UWCubeSat/EPS/README.md

# [Electrical Power System](https://online.huskysatellitelab.com/wiki/index.php/Electrical_Power_System)
