UWCubeSat/EPS/testing boards/BQ25798/BQ25798.kicad_pcb

## KiCad design testing boards/BQ25798/BQ25798.kicad_pcb (2022-05-17)

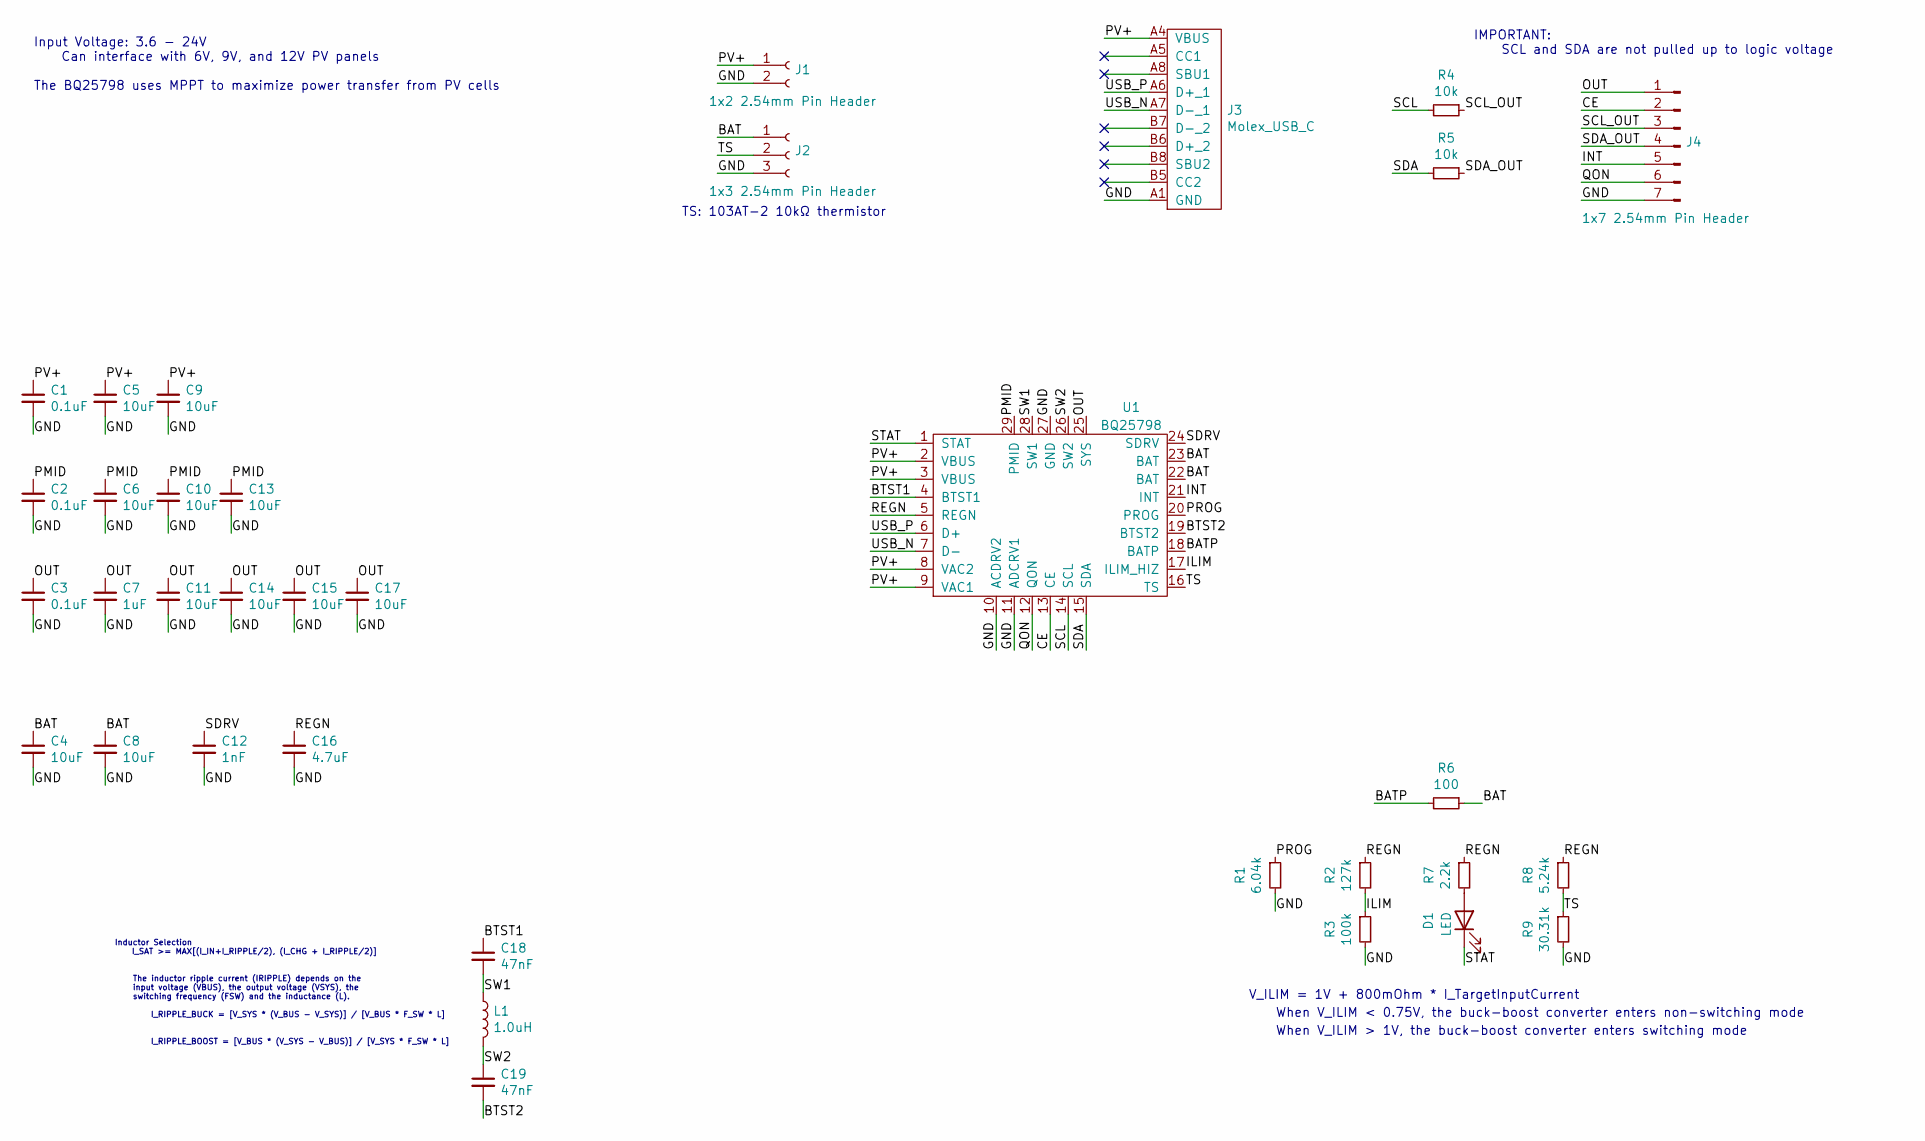
[picture p1: schematic BQ25798.sch]

Parts:
C1, C2, C3: 0.1uF; C_0603_1608Metric
C4, C5, C6, C8, C9, C10, C11, C13, C14, C15, C17: 10uF; C_0603_1608Metric
C7: 1uF; C_0603_1608Metric
C12: 1nF; C_0603_1608Metric
C16: 4.7uF; C_0603_1608Metric
C18, C19: 47nF; C_0603_1608Metric
D1: LED; LED_0402_1005Metric
J1: 1x2 2.54mm Pin Header; PinHeader_1x02_P2.54mm_Vertical
J2: 1x3 2.54mm Pin Header; PinHeader_1x03_P2.54mm_Vertical
J3: Molex_USB_C; USB-C
J4: 1x7 2.54mm Pin Header; PinHeader_1x07_P2.54mm_Vertical
L1: 1.0uH; L_0805_2012Metric
R1: 6.04k; R_0402_1005Metric
R2: 127k; R_0402_1005Metric
R3: 100k; R_0402_1005Metric
R4, R5: 10k; R_0402_1005Metric
R6: 100; R_0402_1005Metric
R7: 2.2k; R_0402_1005Metric
R8: 5.24k; R_0402_1005Metric
R9: 30.31k; R_0402_1005Metric
U1: BQ25798

Connections:
/BAT: C4.1, C8.1, J2.1, R6.1, U1.22 (BAT), U1.23 (BAT)
/BATP: R6.2, U1.18 (BATP)
/BTST1: C18.1, U1.4 (BTST1)
/BTST2: C19.2, U1.19 (BTST2)
/CE: J4.2, U1.13 (CE)
/GND: C1.2, C2.2, C3.2, C4.2, C5.2, C6.2, C7.2, C8.2, C9.2, C10.2, C11.2, C12.2, C13.2, C14.2, C15.2, C16.2, C17.2, J1.2, J2.3, J3.A1 (GND), J4.7, R1.2, R3.2, R9.2, U1.10 (ACDRV2), U1.11 (ADCRV1), U1.27 (GND)
/ILIM: R2.2, R3.1, U1.17 (ILIM_HIZ)
/INT: J4.5, U1.21 (INT)
/OUT: C3.1, C7.1, C11.1, C14.1, C15.1, C17.1, J4.1, U1.25 (SYS)
/PMID: C2.1, C6.1, C10.1, C13.1, U1.29 (PMID)
/PROG: R1.1, U1.20 (PROG)
/PV+: C1.1, C5.1, C9.1, J1.1, J3.A4 (VBUS), U1.2 (VBUS), U1.3 (VBUS), U1.8 (VAC2), U1.9 (VAC1)
/QON: J4.6, U1.12 (QON)
/REGN: C16.1, R2.1, R7.1, R8.1, U1.5 (REGN)
/SCL: R4.2, U1.14 (SCL)
/SCL_OUT: J4.3, R4.1
/SDA: R5.2, U1.15 (SDA)
/SDA_OUT: J4.4, R5.1
/SDRV: C12.1, U1.24 (SDRV)
/STAT: D1.1 (K), U1.1 (STAT)
/SW1: C18.2, L1.1, U1.28 (SW1)
/SW2: C19.1, L1.2, U1.26 (SW2)
/TS: J2.2, R8.2, R9.1, U1.16 (TS)
/USB_N: J3.A7 (D-_1), U1.7 (D-)
/USB_P: J3.A6 (D+_1), U1.6 (D+)
unnamed: D1.2 (A), R7.2

Notes on the sheet:
Input Voltage: 3.6 - 24V Can interface with 6V, 9V, and 12V PV panels The BQ25798 uses MPPT to maximize power transfer from PV cells
Inductor Selection I_SAT >= MAX[(I_IN+I_RIPPLE/2), (I_CHG + I_RIPPLE/2)]
I_RIPPLE_BUCK = [V_SYS * (V_BUS - V_SYS)] / [V_BUS * F_SW * L]
I_RIPPLE_BOOST = [V_BUS * (V_SYS - V_BUS)] / [V_SYS * F_SW * L]
The inductor ripple current (IRIPPLE) depends on the input voltage (VBUS), the output voltage (VSYS), the switching frequency (FSW) and the inductance (L).
V_ILIM = 1V + 800mOhm * I_TargetInputCurrent
When V_ILIM < 0.75V, the buck-boost converter enters non-switching mode
When V_ILIM > 1V, the buck-boost converter enters switching mode
IMPORTANT: SCL and SDA are not pulled up to logic voltage
TS: 103AT-2 10kΩ thermistor

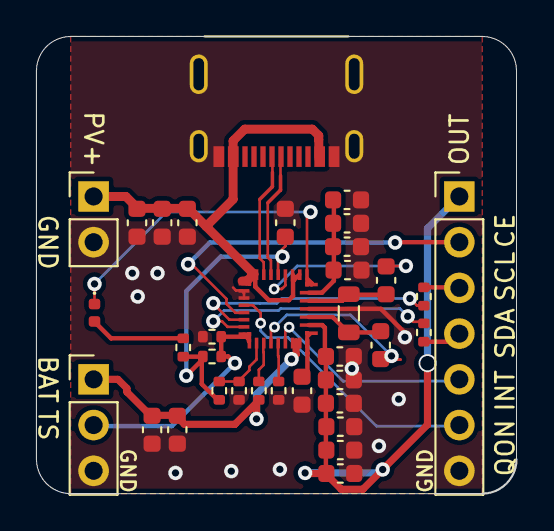
[picture p2: board BQ25798.kicad_pcb from above]

Board: 2 copper layers, 26.7 x 25.4 mm, 35 parts (0 on the bottom side), 26 nets.
