UWCubeSat/EPS/testing boards/EFuse_and_Load_Switch/EFuse_and_Load_Switch.kicad_pcb

## KiCad design testing boards/EFuse_and_Load_Switch/EFuse_and_Load_Switch.kicad_pcb (2022-05-17)

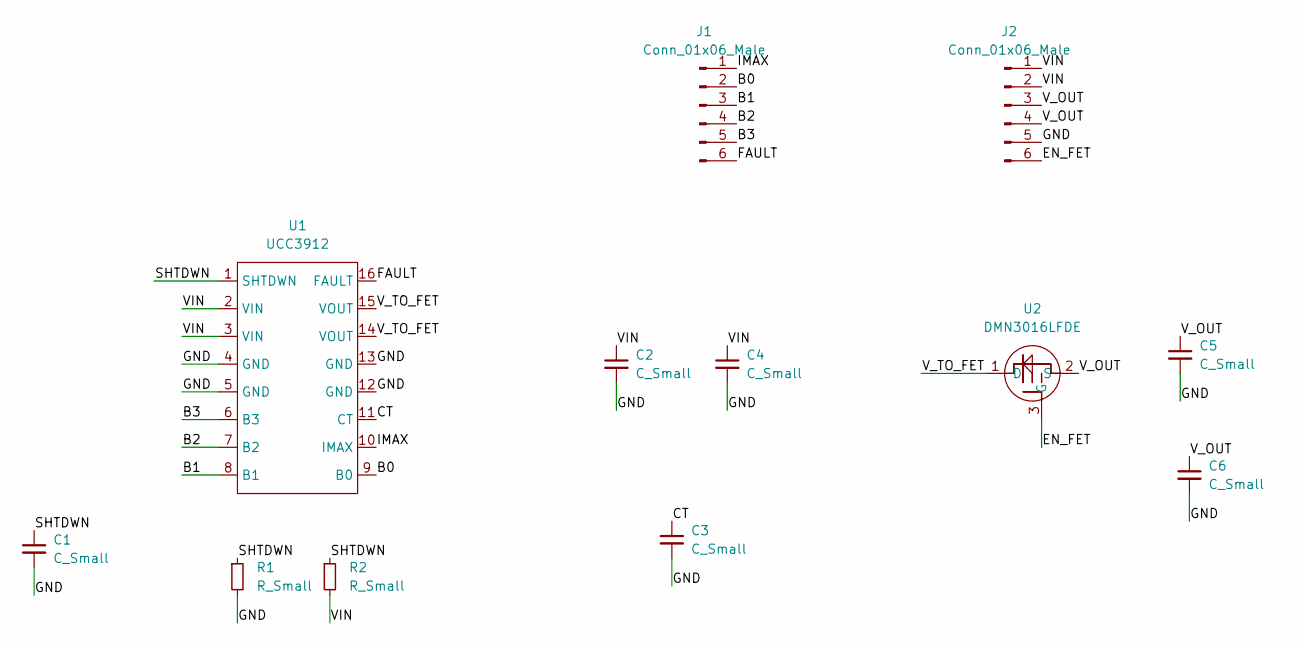
[picture p3: schematic EFuse_and_Load_Switch.kicad_sch]

Parts:
C1, C2, C3, C4, C5, C6: C_Small; C_0603_1608Metric
J1, J2: Conn_01x06_Male; PinHeader_1x06_P2.54mm_Vertical
R1, R2: R_Small; R_0402_1005Metric
U1: UCC3912
U2: DMN3016LFDE; U-DFN2020-6

Connections:
/B0: J1.2, U1.9 (B0)
/B1: J1.3, U1.8 (B1)
/B2: J1.4, U1.7 (B2)
/B3: J1.5, U1.6 (B3)
/CT: C3.1, U1.11 (CT)
/EN_FET: J2.6, U2.3 (G)
/FAULT: J1.6, U1.16 (FAULT)
/GND: C1.2, C2.2, C3.2, C4.2, C5.2, C6.2, J2.5, R1.2, U1.4 (GND), U1.5 (GND), U1.12 (GND), U1.13 (GND)
/IMAX: J1.1, U1.10 (IMAX)
/SHTDWN: C1.1, R1.1, R2.1, U1.1 (SHTDWN)
/VIN: C2.1, C4.1, J2.1, J2.2, R2.2, U1.2 (VIN), U1.3 (VIN)
/V_OUT: C5.1, C6.1, J2.3, J2.4, U2.2 (S)
/V_TO_FET: U1.14 (VOUT), U1.15 (VOUT), U2.1 (D)

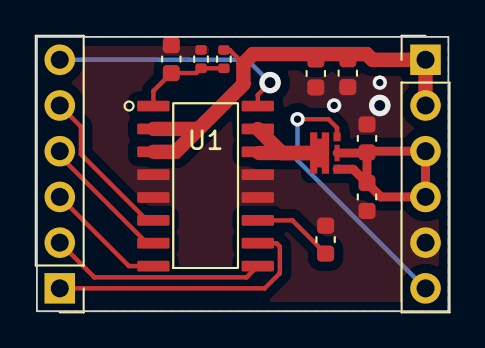
[picture p4: board EFuse_and_Load_Switch.kicad_pcb from above]

Board: 2 copper layers, 22.9 x 15.2 mm, 12 parts (0 on the bottom side), 13 nets.
