UWCubeSat/EPS/testing boards/BQ2920x/BQ2920x.kicad_pcb

## KiCad design testing boards/BQ2920x/BQ2920x.kicad_pcb (2022-05-17)

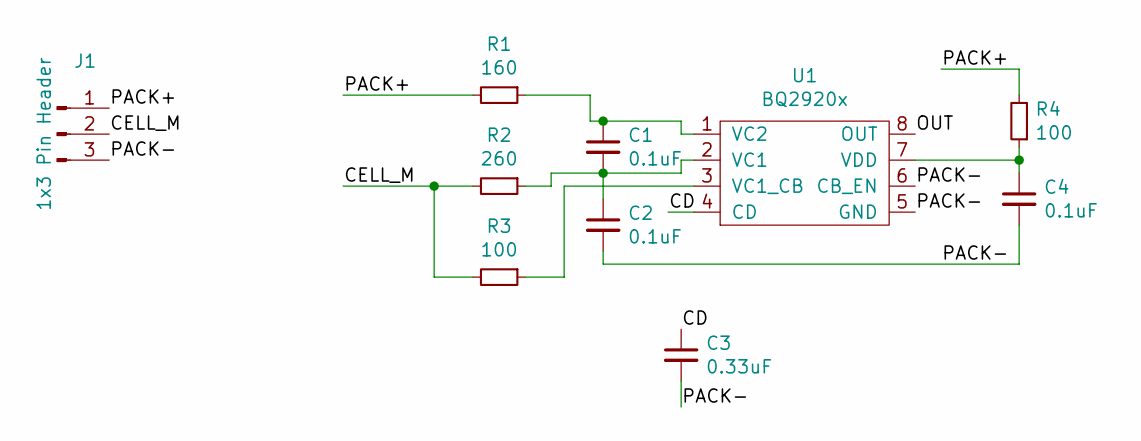
[picture p5: schematic BQ2920x.sch]

Parts:
C1, C2, C4: 0.1uF; C_0603_1608Metric
C3: 0.33uF; C_0603_1608Metric
J1: 1x3 Pin Header; PinHeader_1x03_P2.54mm_Vertical
R1: 160; R_0402_1005Metric
R2: 260; R_0402_1005Metric
R3, R4: 100; R_0402_1005Metric
U1: BQ2920x

Connections:
/CD: C3.1, U1.4 (CD)
/CELL_M: J1.2, R2.2, R3.2
/OUT: U1.8 (OUT)
/PACK+: J1.1, R1.2, R4.2
/PACK-: C2.2, C3.2, C4.2, J1.3, U1.5 (GND), U1.6 (CB_EN)
unnamed: C1.1, R1.1, U1.1 (VC2)
unnamed: C1.2, C2.1, R2.1, U1.2 (VC1)
unnamed: C4.1, R4.1, U1.7 (VDD)
unnamed: R3.1, U1.3 (VC1_CB)

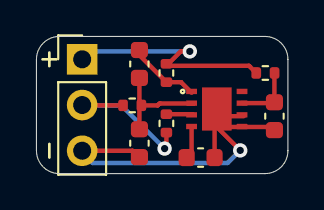
[picture p6: board BQ2920x.kicad_pcb from above]

Board: 2 copper layers, 14.0 x 7.6 mm, 10 parts (0 on the bottom side), 8 nets.
