UWCubeSat/EPS/testing boards/INA219/INA219_Breakout/INA219_Breakout.kicad_pcb

## KiCad design testing boards/INA219/INA219_Breakout/INA219_Breakout.kicad_pcb (2022-05-17)

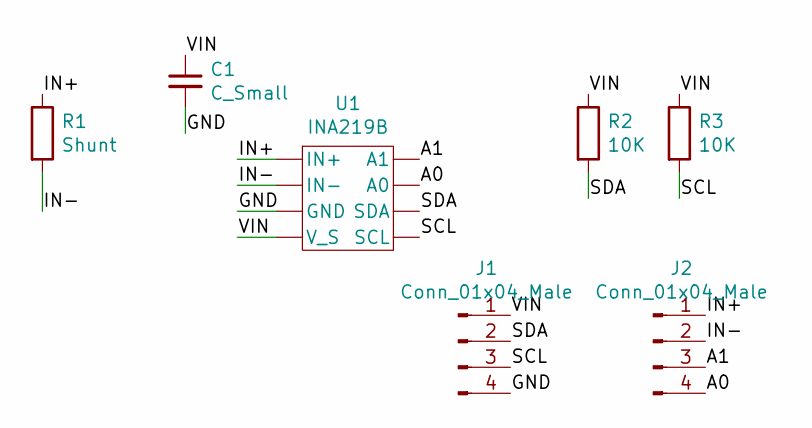
[picture p7: schematic INA219_Breakout.kicad_sch]

Parts:
C1: C_Small; C_0603_1608Metric
J1, J2: Conn_01x04_Male; PinHeader_1x04_P2.54mm_Vertical
R1: Shunt; R_2512_6332Metric
R2, R3: 10K; R_0402_1005Metric
U1: INA219B; SOT-23-8

Connections:
/A0: J2.4, U1.7 (A0)
/A1: J2.3, U1.8 (A1)
/GND: C1.2, J1.4, U1.3 (GND)
/IN+: J2.1, R1.1, U1.1 (IN+)
/IN-: J2.2, R1.2, U1.2 (IN-)
/SCL: J1.3, R3.2, U1.5 (SCL)
/SDA: J1.2, R2.2, U1.6 (SDA)
/VIN: C1.1, J1.1, R2.1, R3.1, U1.4 (V_S)

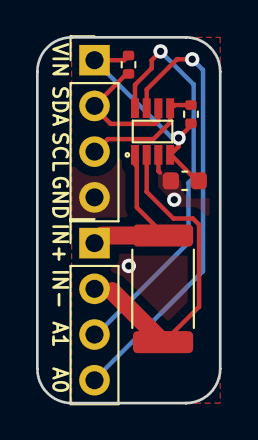
[picture p8: board INA219_Breakout.kicad_pcb from above]

Board: 2 copper layers, 10.2 x 20.3 mm, 7 parts (0 on the bottom side), 8 nets.
