UWCubeSat/EPS/testing boards/BQ298xyz/BQ298xyz.kicad_pcb

## KiCad design testing boards/BQ298xyz/BQ298xyz.kicad_pcb (2022-05-17)

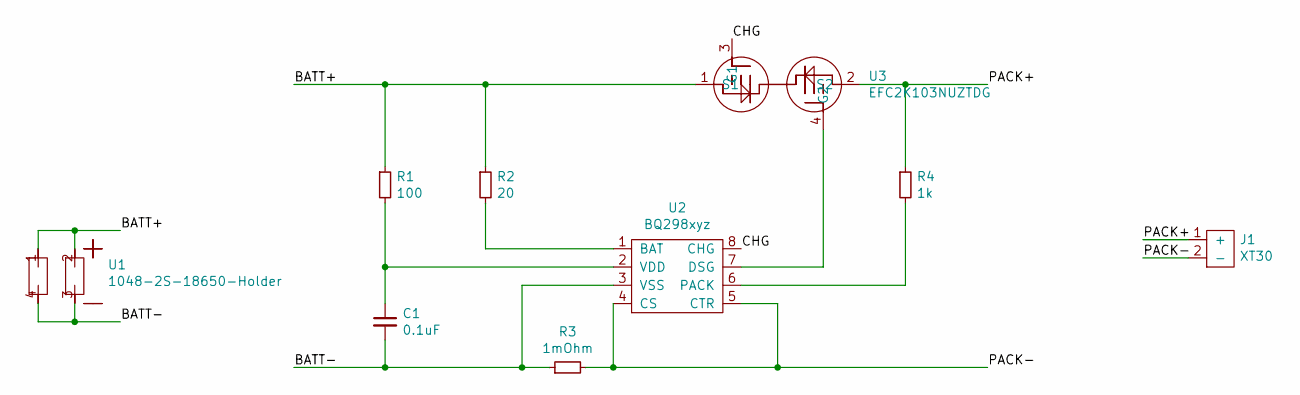
[picture p9: schematic BQ298xyz.sch]

Parts:
C1: 0.1uF; C_0201_0603Metric
J1: XT30
R1: 100; R_0402_1005Metric
R2: 20; R_0402_1005Metric
R3: 1mOhm; R_2512_6332Metric
R4: 1k; R_0402_1005Metric
U1: 1048-2S-18650-Holder; 1048-2S-18650
U2: BQ298xyz
U3: EFC2K103NUZTDG

Connections:
/BATT+: R1.1, R2.1, U1.1, U1.2, U3.1 (S1)
/BATT-: C1.2, R3.1, U1.3, U1.4, U2.3 (VSS)
/CHG: U2.8 (CHG), U3.3 (G1)
/PACK+: J1.1 (+), R4.1, U3.2 (S2)
/PACK-: J1.2 (-), R3.2, U2.4 (CS), U2.5 (CTR)
unnamed: C1.1, R1.2, U2.2 (VDD)
unnamed: R2.2, U2.1 (BAT)
unnamed: R4.2, U2.6 (PACK)
unnamed: U2.7 (DSG), U3.4 (G2)

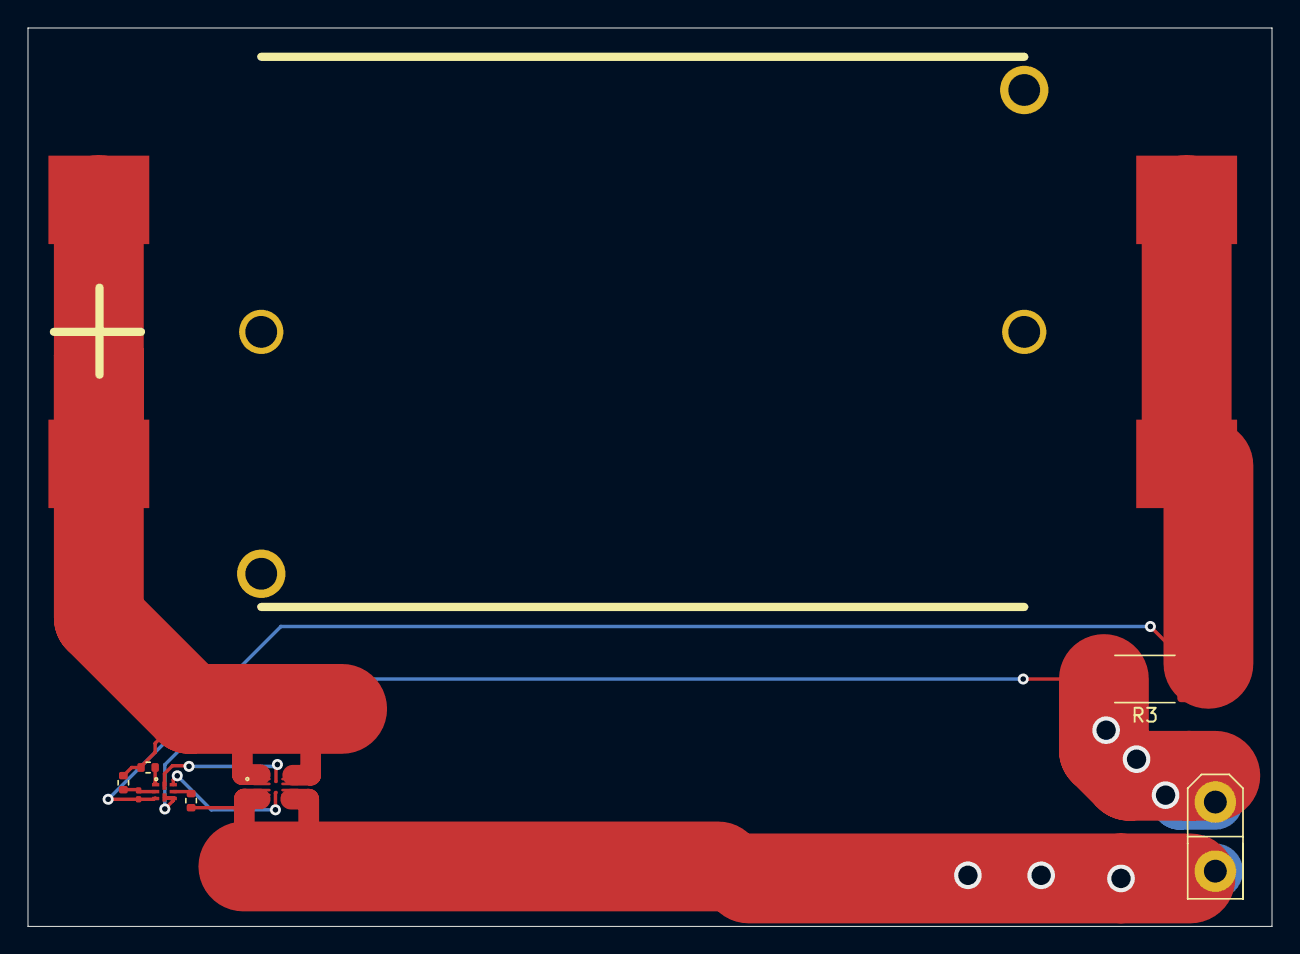
[picture p10: board BQ298xyz.kicad_pcb from above]

Board: 2 copper layers, 90.0 x 65.0 mm, 9 parts (0 on the bottom side), 9 nets.
