UWCubeSat/EPS/testing boards/TPS2595x1_Breakout/TPS2595x1_Breakout.kicad_pcb

## KiCad design testing boards/TPS2595x1_Breakout/TPS2595x1_Breakout.kicad_pcb (2022-05-17)

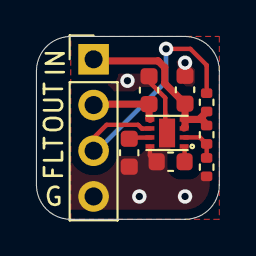
[picture p11: board TPS2595x1_Breakout.kicad_pcb from above]

Board: 2 copper layers, 10.2 x 10.2 mm, 9 parts (0 on the bottom side), 7 nets.

Parts:
C1, C2, C3, C4: 1uF; C_0603_1608Metric
J1: Pin Header; PinHeader_1x04_P2.54mm_Vertical
R1, R2, R3: 10K; R_0402_1005Metric
U1: TPS2595x1

Connections:
/EN: R1.2, R2.1, U1.2
/FLT: J1.3, R3.2, U1.6
/GND: C1.2, C2.2, C3.2, C4.2, J1.4, R2.2, U1.8
/ILM: C2.1, U1.7
/IN: C3.1, J1.1, R1.1, R3.1, U1.3, U1.4
/OUT: C4.1, J1.2, U1.5
/dVdt: C1.1, U1.1
