UWCubeSat/EPS/testing boards/CurrentMeasuringWithProtection/CurrentMeasuringWithProtection.kicad_pcb

## KiCad design testing boards/CurrentMeasuringWithProtection/CurrentMeasuringWithProtection.kicad_pcb (2022-05-17)

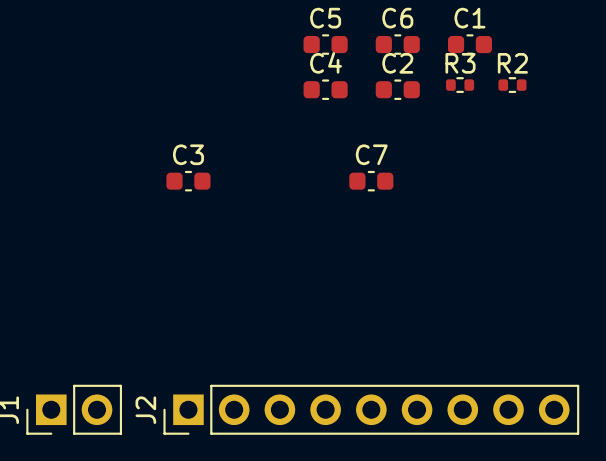
[picture p12: board CurrentMeasuringWithProtection.kicad_pcb from above]

Board: 2 copper layers, 11 parts (0 on the bottom side), 6 nets, no tracks yet.

Parts:
C1, C2, C3, C4, C5, C6, C7: C_Small; C_0603_1608Metric
J1: Conn_01x02_Male; PinHeader_1x02_P2.54mm_Vertical
J2: Conn_01x09_Male; PinHeader_1x09_P2.54mm_Vertical
R2, R3: R_Small; R_0402_1005Metric

Connections:
/3V3: J2.1, R2.1, R3.1
/GND: C1.2, C2.2, C3.2, C4.2, C5.2, C6.2, C7.2, J2.9
/IN+: C1.1, C2.1, J1.1
/SCL: J2.5, R3.2
/SDA: J2.4, R2.2
/V_OUT: C6.1, C7.1, J1.2
