UWCubeSat/EPS/eps/eps.kicad_pcb

## KiCad design eps/eps.kicad_pcb (2021-06-19)

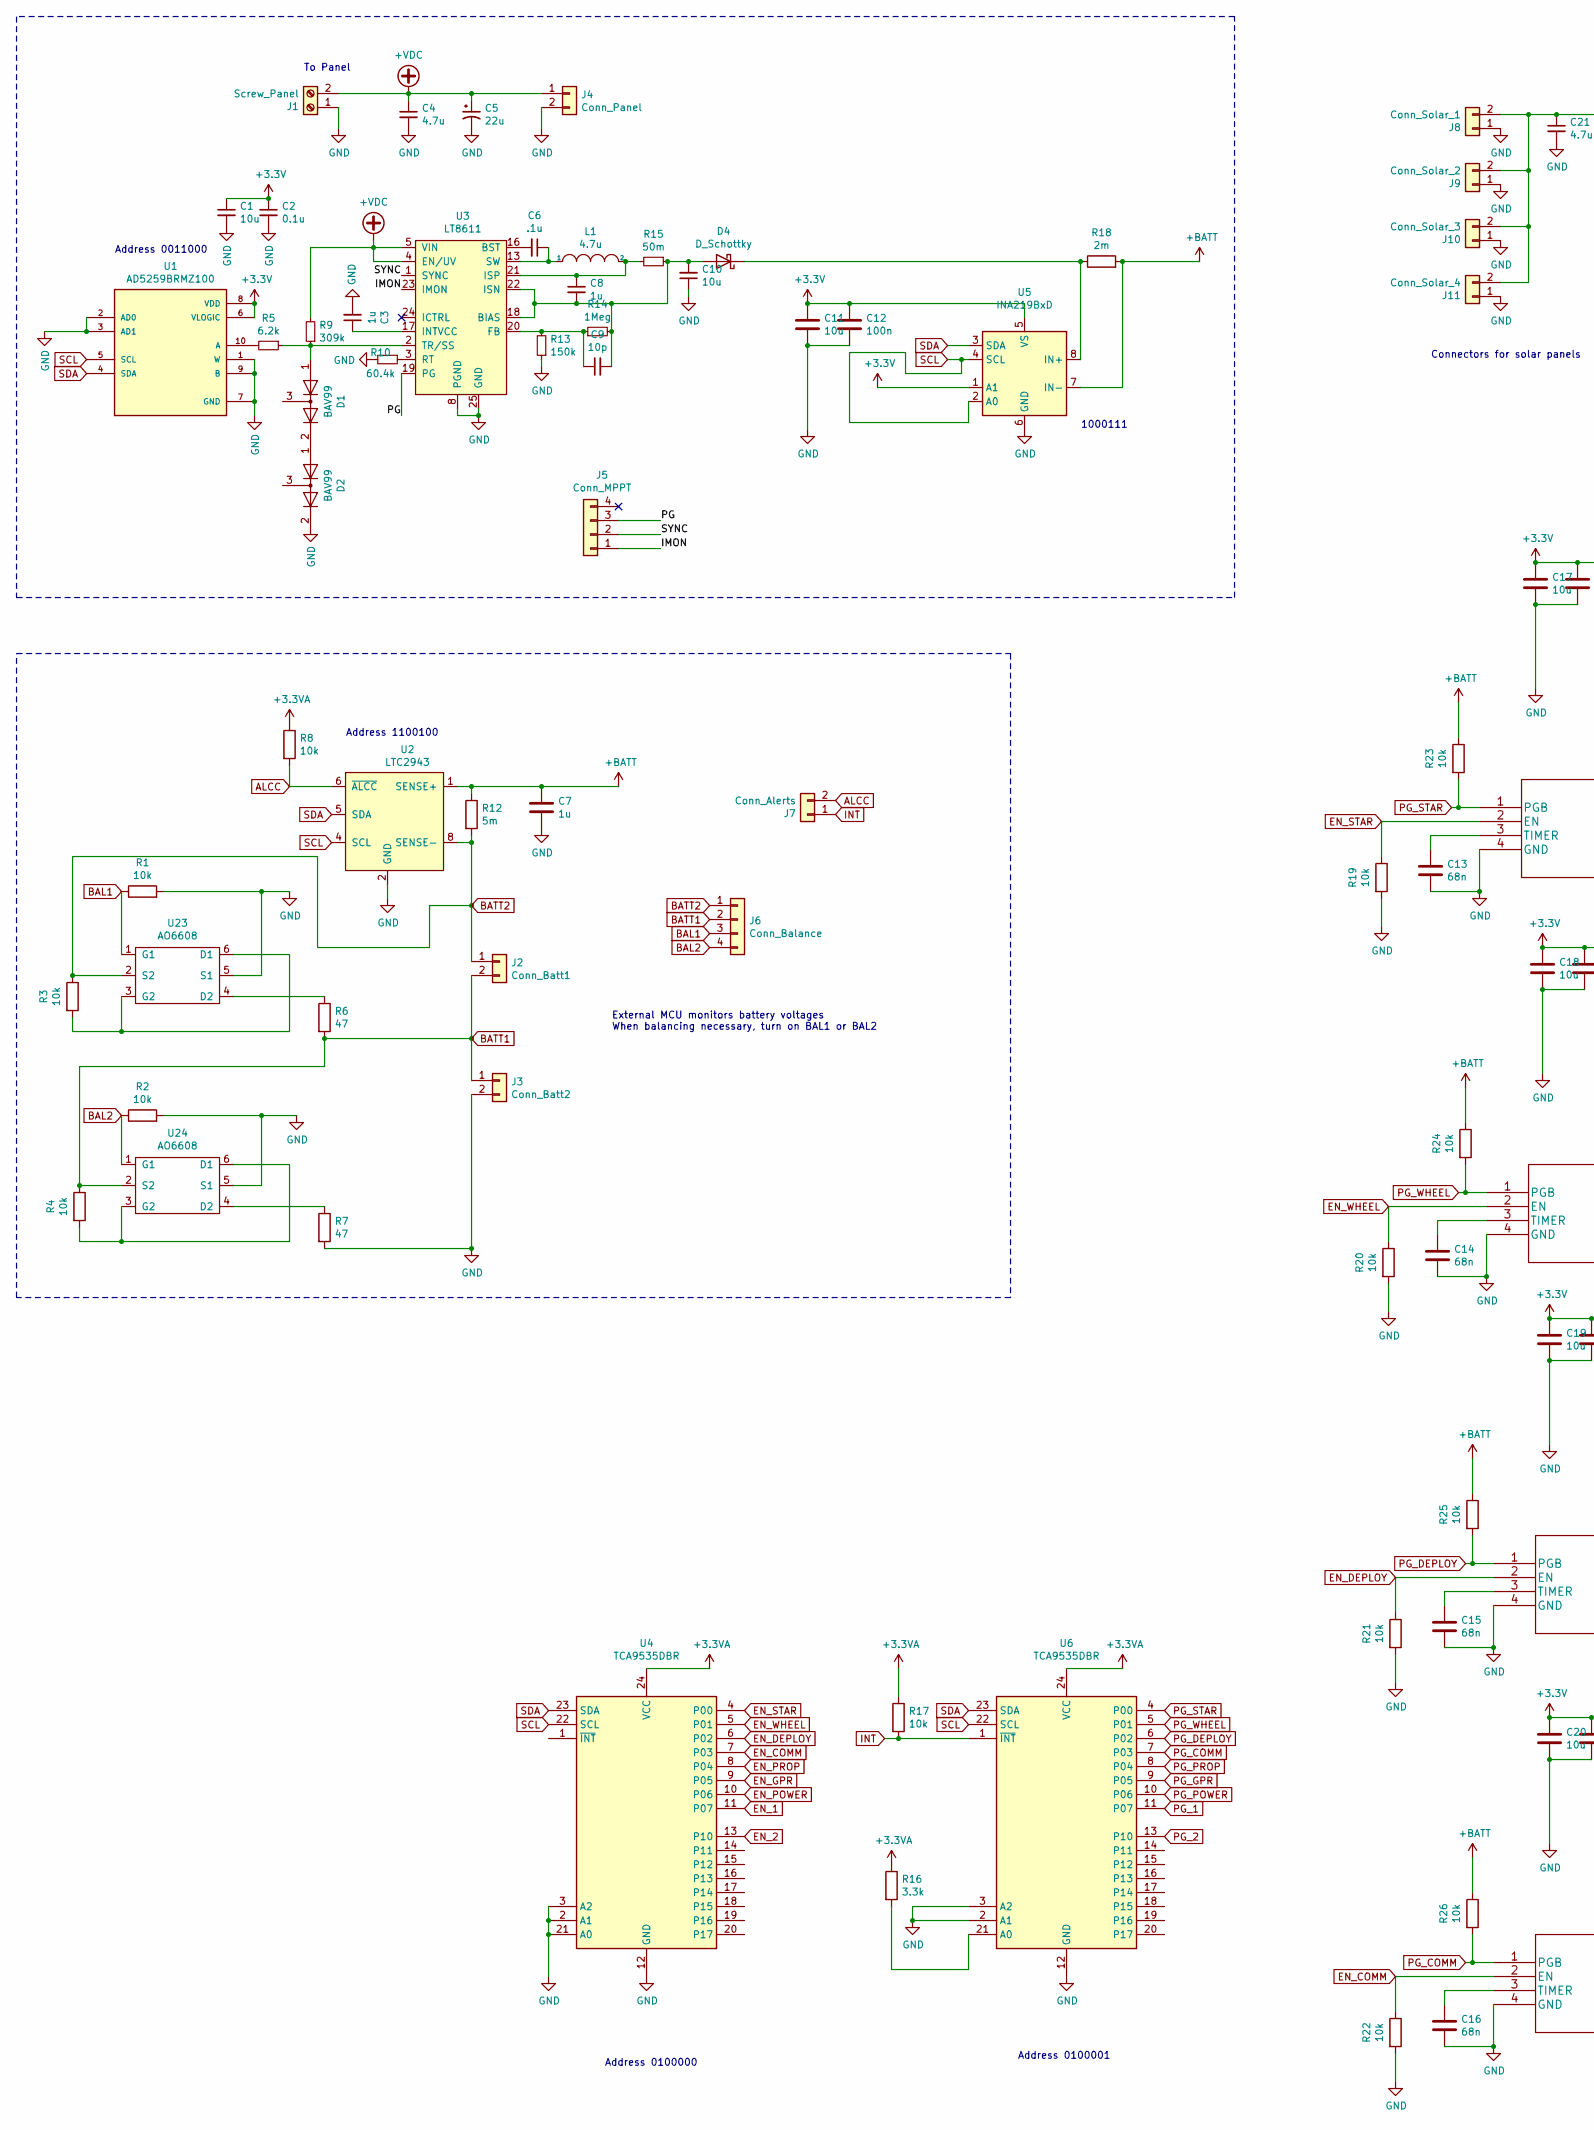
[picture p13: schematic eps.sch, EPS Board, part in row 1, column 1]

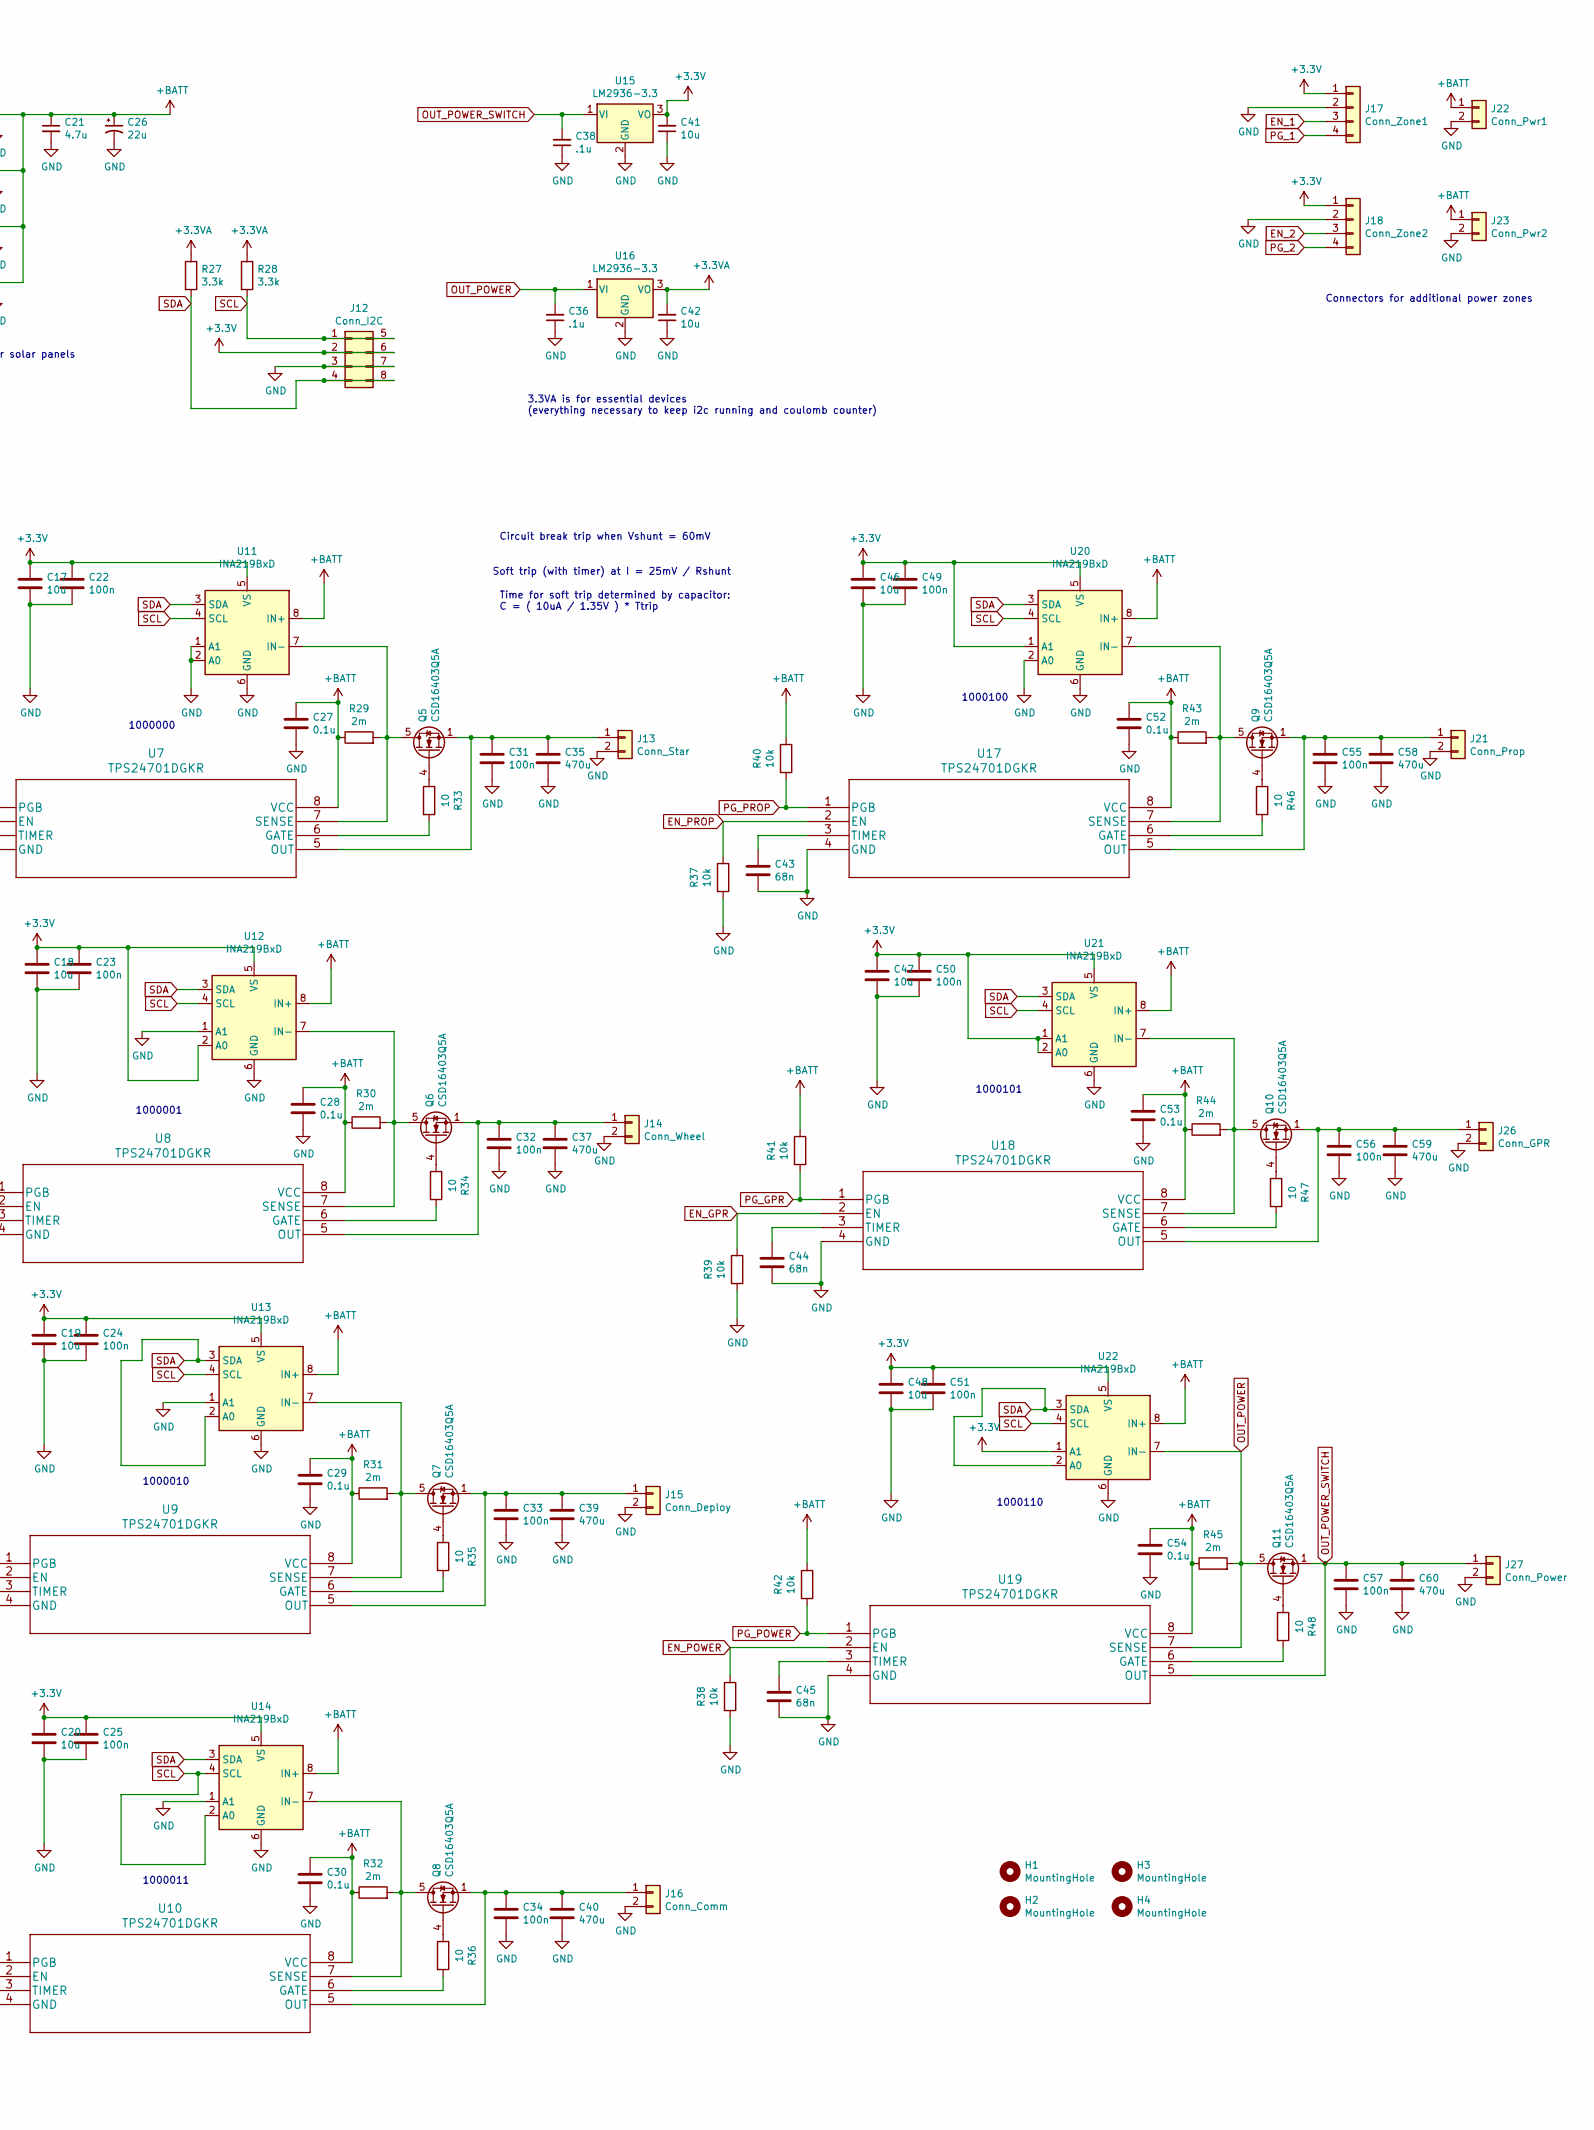
[picture p14: schematic eps.sch, EPS Board, part in row 1, column 2]

Parts:
C1, C10, C11, C17, C18, C19, C20, C41, C42, C46, C47, C48: 10u; C_0805_2012Metric_Pad1.18x1.45mm_HandSolder; Part C15850
C2, C27, C28, C29, C30, C52, C53, C54: 0.1u; C_0805_2012Metric_Pad1.18x1.45mm_HandSolder; Part C49678
C3, C7, C8: 1u; C_0805_2012Metric_Pad1.18x1.45mm_HandSolder; Part C28323
C4, C21: 4.7u; C_0805_2012Metric_Pad1.18x1.45mm_HandSolder; Part C1779
C5, C26: 22u; CP_Radial_D6.3mm_P2.50mm
C6, C36, C38: .1u; C_0805_2012Metric_Pad1.18x1.45mm_HandSolder; Part C49678
C9: 10p; C_0805_2012Metric_Pad1.18x1.45mm_HandSolder; Part C1785
C12, C22, C23, C24, C25, C31, C32, C33, C34, C49, C50, C51, C55, C56, C57: 100n; C_0805_2012Metric_Pad1.18x1.45mm_HandSolder; Part C49678
C13, C14, C15, C16, C43, C44, C45: 68n; C_0805_2012Metric_Pad1.18x1.45mm_HandSolder; Part C1756
C35, C37, C39, C40, C58, C59, C60: 470u; CP_Radial_D8.0mm_P3.50mm
D1, D2: BAV99; SOT-23; Part C2500
D4: D_Schottky; D_SOD-128
H1, H2, H3, H4: MountingHole; MountingHole_2.7mm_M2.5_Pad_Via; Part x
J1: Screw_Panel; TerminalBlock_Phoenix_PT-1,5-2-5.0-H_1x02_P5.00mm_Horizontal
J2: Conn_Batt1; Molex_Micro-Fit_3.0_43045-0212_2x01_P3.00mm_Vertical
J3: Conn_Batt2; Molex_Micro-Fit_3.0_43045-0212_2x01_P3.00mm_Vertical
J4: Conn_Panel; JST_XH_B2B-XH-AM_1x02_P2.50mm_Vertical
J5: Conn_MPPT; JST_XH_B4B-XH-AM_1x04_P2.50mm_Vertical
J6: Conn_Balance; JST_XH_B4B-XH-AM_1x04_P2.50mm_Vertical
J7: Conn_Alerts; JST_XH_B2B-XH-AM_1x02_P2.50mm_Vertical
J8: Conn_Solar_1; JST_XH_B2B-XH-AM_1x02_P2.50mm_Vertical
J9: Conn_Solar_2; JST_XH_B2B-XH-AM_1x02_P2.50mm_Vertical
J10: Conn_Solar_3; JST_XH_B2B-XH-AM_1x02_P2.50mm_Vertical
J11: Conn_Solar_4; JST_XH_B2B-XH-AM_1x02_P2.50mm_Vertical
J12: Conn_I2C; JST_PHD_B8B-PHDSS_2x04_P2.00mm_Vertical
J13: Conn_Star; Molex_Micro-Fit_3.0_43045-0212_2x01_P3.00mm_Vertical
J14: Conn_Wheel; Molex_Micro-Fit_3.0_43045-0212_2x01_P3.00mm_Vertical
J15: Conn_Deploy; Molex_Micro-Fit_3.0_43045-0212_2x01_P3.00mm_Vertical
J16: Conn_Comm; Molex_Micro-Fit_3.0_43045-0212_2x01_P3.00mm_Vertical
J17: Conn_Zone1; JST_XH_B4B-XH-AM_1x04_P2.50mm_Vertical
J18: Conn_Zone2; JST_XH_B4B-XH-AM_1x04_P2.50mm_Vertical
J21: Conn_Prop; Molex_Micro-Fit_3.0_43045-0212_2x01_P3.00mm_Vertical
J22: Conn_Pwr1; Molex_Micro-Fit_3.0_43045-0212_2x01_P3.00mm_Vertical
J23: Conn_Pwr2; Molex_Micro-Fit_3.0_43045-0212_2x01_P3.00mm_Vertical
J26: Conn_GPR; Molex_Micro-Fit_3.0_43045-0212_2x01_P3.00mm_Vertical
J27: Conn_Power; Molex_Micro-Fit_3.0_43045-0212_2x01_P3.00mm_Vertical
L1: 4.7u; BWVS00606045
Q5, Q6, Q7, Q8, Q9, Q10, Q11: CSD16403Q5A; TDSON-8-1
R1, R2, R3, R4, R8, R17, R19, R20, R21, R22, R23, R24, R25, R26, R37, R38, R39, R40, R41, R42: 10k; R_0805_2012Metric_Pad1.20x1.40mm_HandSolder; Part C17414
R5: 6.2k; R_0805_2012Metric_Pad1.20x1.40mm_HandSolder; Part C17767
R6, R7: 47; R_2512_6332Metric_Pad1.40x3.35mm_HandSolder
R9: 309k; R_0805_2012Metric_Pad1.20x1.40mm_HandSolder
R10: 60.4k; R_0805_2012Metric_Pad1.20x1.40mm_HandSolder
R12: 5m; R_2512_6332Metric_Pad1.40x3.35mm_HandSolder
R13: 150k; R_0805_2012Metric_Pad1.20x1.40mm_HandSolder; Part C17470
R14: 1Meg; R_0805_2012Metric_Pad1.20x1.40mm_HandSolder; Part C17514
R15: 50m; R_2512_6332Metric_Pad1.40x3.35mm_HandSolder
R16, R27, R28: 3.3k; R_0805_2012Metric_Pad1.20x1.40mm_HandSolder; Part C26010
R18, R29, R30, R31, R32, R43, R44, R45: 2m; R_0805_2012Metric_Pad1.20x1.40mm_HandSolder
R33, R34, R35, R36, R46, R47, R48: 10; R_0805_2012Metric_Pad1.20x1.40mm_HandSolder; Part C17415
U1: AD5259BRMZ100; SOP50P490X95-10N
U2: LTC2943; DFN-8-1EP_3x3mm_P0.5mm_EP1.66x2.38mm
U3: LT8611; 24-QFN_3x5
U4, U6: TCA9535DBR; SSOP-24_5.3x8.2mm_P0.65mm
U5, U11, U12, U13, U14, U20, U21, U22: INA219BxD; SOIC-8_3.9x4.9mm_P1.27mm
U7, U8, U9, U10, U17, U18, U19: TPS24701DGKR
U15, U16: LM2936-3.3; SOT-223-3_TabPin2
U23, U24: AO6608; SOT-23-6_Handsoldering

Connections:
+3.3VA: C42.2, R8.1, R16.1, R17.1, R27.1, R28.1, U4.24 (VCC), U6.24 (VCC), U16.3 (VO)
+3V3: C1.1, C2.1, C11.1, C12.1, C17.1, C18.1, C19.1, C20.1, C22.1, C23.1, C24.1, C25.1, C41.2, C46.1, C47.1, C48.1, C49.1, C50.1, C51.1, J12.2, J12.6, J17.1, J18.1, U1.6 (VLOGIC), U1.8 (VDD), U5.1 (A1), U5.5 (VS), U11.5 (VS), U12.2 (A0), U12.5 (VS), U13.5 (VS), U14.5 (VS), U15.3 (VO), U20.1 (A1), U20.5 (VS), U21.1 (A1), U21.2 (A0), U21.5 (VS), U22.1 (A1), U22.5 (VS)
+BATT: C7.1, C21.1, C26.1, C27.1, C28.1, C29.1, C30.1, C52.1, C53.1, C54.1, J8.2, J9.2, J10.2, J11.2, J22.1, J23.1, R12.1, R18.2, R23.1, R24.1, R25.1, R26.1, R29.1, R30.1, R31.1, R32.1, R40.1, R41.1, R42.1, R43.1, R44.1, R45.1, U2.1 (SENSE+), U5.7 (IN-), U7.8 (VCC), U8.8 (VCC), U9.8 (VCC), U10.8 (VCC), U11.8 (IN+), U12.8 (IN+), U13.8 (IN+), U14.8 (IN+), U17.8 (VCC), U18.8 (VCC), U19.8 (VCC), U20.8 (IN+), U21.8 (IN+), U22.8 (IN+)
+VDC: C4.1, C5.1, J1.2, J4.1, R9.2, U3.4 (EN/UV), U3.5 (VIN), U3.6 (VIN)
/IMON: J5.1, U3.23 (IMON)
/PG: J5.3, U3.19 (PG)
/SYNC: J5.2, U3.1 (SYNC)
ALCC: J7.2, R8.2, U2.6 (~ALCC~)
BAL1: J6.3, R1.1, U23.1 (G1)
BAL2: J6.4, R2.1, U24.1 (G1)
BATT1: J2.2, J3.1, J6.2, R4.1, R6.2, U24.2 (S2)
BATT2: J2.1, J6.1, R3.1, R12.2, U2.8 (SENSE-), U23.2 (S2)
EN_1: J17.3, U4.11 (P07)
EN_2: J18.3, U4.13 (P10)
EN_COMM: R22.1, U4.7 (P03), U10.2 (EN)
EN_DEPLOY: R21.1, U4.6 (P02), U9.2 (EN)
EN_GPR: R39.1, U4.9 (P05), U18.2 (EN)
EN_POWER: R38.1, U4.10 (P06), U19.2 (EN)
EN_PROP: R37.1, U4.8 (P04), U17.2 (EN)
EN_STAR: R19.1, U4.4 (P00), U7.2 (EN)
EN_WHEEL: R20.1, U4.5 (P01), U8.2 (EN)
GND: C1.2, C2.2, C3.2, C4.2, C5.2, C7.2, C10.1, C11.2, C12.2, C13.2, C14.2, C15.2, C16.2, C17.2, C18.2, C19.2, C20.2, C21.2, C22.2, C23.2, C24.2, C25.2, C26.2, C27.2, C28.2, C29.2, C30.2, C31.2, C32.2, C33.2, C34.2, C35.2, C36.1, C37.2, C38.1, C39.2, C40.2, C41.1, C42.1, C43.2, C44.2, C45.2, C46.2, C47.2, C48.2, C49.2, C50.2, C51.2, C52.2, C53.2, C54.2, C55.2, C56.2, C57.2, C58.2, C59.2, C60.2, D2.2 (A), J1.1, J3.2, J4.2, J8.1, J9.1, J10.1, J11.1, J12.3, J12.7, J13.2, J14.2, J15.2, J16.2, J17.2, J18.2, J21.2, J22.2, J23.2, J26.2, J27.2, R1.2, R2.2, R7.2, R10.2, R13.1, R19.2, R20.2, R21.2, R22.2, R37.2, R38.2, R39.2, U1.1 (W), U1.2 (AD0), U1.3 (AD1), U1.7 (GND), U1.9 (B), U2.2 (GND), U2.3 (NC), U2.7 (NC), U2.9, U3.7 (PGND), U3.8 (PGND), U3.9 (NC), U3.10 (NC), U3.11 (NC), U3.12 (NC), U3.25 (GND), U4.2 (A1), U4.3 (A2), U4.12 (GND), U4.21 (A0), U5.6 (GND), U6.2 (A1), U6.3 (A2), U6.12 (GND), U7.4 (GND), U8.4 (GND), U9.4 (GND), U10.4 (GND), U11.1 (A1), U11.2 (A0), U11.6 (GND), U12.1 (A1), U12.6 (GND), U13.1 (A1), U13.6 (GND), U14.1 (A1), U14.6 (GND), U15.2 (GND), U16.2 (GND), U17.4 (GND), U18.4 (GND), U19.4 (GND), U20.2 (A0), U20.6 (GND), U21.6 (GND), U22.6 (GND), U23.5 (S1), U24.5 (S1)
INT: J7.1, R17.2, U6.1 (~INT)
unnamed: C3.1, U3.17 (INTVCC)
unnamed: C6.1, L1.1, U3.13 (SW), U3.14 (SW), U3.15 (SW)
unnamed: C6.2, U3.16 (BST)
unnamed: C8.1, L1.2, R15.2, U3.21 (ISP)
unnamed: C9.1, R13.2, R14.1, U3.20 (FB)
unnamed: C8.2, C9.2, C10.2, D4.2 (A), R14.2, R15.1, U3.18 (BIAS), U3.22 (ISN)
unnamed: C13.1, U7.3 (TIMER)
unnamed: C14.1, U8.3 (TIMER)
unnamed: C15.1, U9.3 (TIMER)
unnamed: C16.1, U10.3 (TIMER)
unnamed: C31.1, C35.1, J13.1, Q5.1 (S), Q5.2 (S), Q5.3 (S), U7.5 (OUT)
unnamed: C32.1, C37.1, J14.1, Q6.1 (S), Q6.2 (S), Q6.3 (S), U8.5 (OUT)
unnamed: C33.1, C39.1, J15.1, Q7.1 (S), Q7.2 (S), Q7.3 (S), U9.5 (OUT)
unnamed: C34.1, C40.1, J16.1, Q8.1 (S), Q8.2 (S), Q8.3 (S), U10.5 (OUT)
unnamed: C43.1, U17.3 (TIMER)
unnamed: C44.1, U18.3 (TIMER)
unnamed: C45.1, U19.3 (TIMER)
unnamed: C55.1, C58.1, J21.1, Q9.1 (S), Q9.2 (S), Q9.3 (S), U17.5 (OUT)
unnamed: C56.1, C59.1, J26.1, Q10.1 (S), Q10.2 (S), Q10.3 (S), U18.5 (OUT)
unnamed: D1.1 (K), R5.1, R9.1, U3.2 (TR/SS)
unnamed: D1.2 (A), D2.1 (K)
unnamed: D4.1 (K), R18.1, U5.8 (IN+)
unnamed: Q5.4 (G), R33.1
unnamed: Q5.5 (D), R29.2, U7.7 (SENSE), U11.7 (IN-)
unnamed: Q6.4 (G), R34.1
unnamed: Q6.5 (D), R30.2, U8.7 (SENSE), U12.7 (IN-)
unnamed: Q7.4 (G), R35.1
unnamed: Q7.5 (D), R31.2, U9.7 (SENSE), U13.7 (IN-)
unnamed: Q8.4 (G), R36.1
unnamed: Q8.5 (D), R32.2, U10.7 (SENSE), U14.7 (IN-)
unnamed: Q9.4 (G), R46.1
unnamed: Q9.5 (D), R43.2, U17.7 (SENSE), U20.7 (IN-)
unnamed: Q10.4 (G), R47.1
unnamed: Q10.5 (D), R44.2, U18.7 (SENSE), U21.7 (IN-)
unnamed: Q11.4 (G), R48.1
unnamed: R3.2, U23.3 (G2), U23.6 (D1)
unnamed: R4.2, U24.3 (G2), U24.6 (D1)
unnamed: R5.2, U1.10 (A)
unnamed: R6.1, U23.4 (D2)
unnamed: R7.1, U24.4 (D2)
unnamed: R10.1, U3.3 (RT)
unnamed: R16.2, U6.21 (A0)
unnamed: R33.2, U7.6 (GATE)
unnamed: R34.2, U8.6 (GATE)
unnamed: R35.2, U9.6 (GATE)
unnamed: R36.2, U10.6 (GATE)
unnamed: R46.2, U17.6 (GATE)
unnamed: R47.2, U18.6 (GATE)
unnamed: R48.2, U19.6 (GATE)
OUT_POWER: C36.2, Q11.5 (D), R45.2, U16.1 (VI), U19.7 (SENSE), U22.7 (IN-)
OUT_POWER_SWITCH: C38.2, C57.1, C60.1, J27.1, Q11.1 (S), Q11.2 (S), Q11.3 (S), U15.1 (VI), U19.5 (OUT)
PG_1: J17.4, U6.11 (P07)
PG_2: J18.4, U6.13 (P10)
PG_COMM: R26.2, U6.7 (P03), U10.1 (PGB)
PG_DEPLOY: R25.2, U6.6 (P02), U9.1 (PGB)
PG_GPR: R41.2, U6.9 (P05), U18.1 (PGB)
PG_POWER: R42.2, U6.10 (P06), U19.1 (PGB)
PG_PROP: R40.2, U6.8 (P04), U17.1 (PGB)
PG_STAR: R23.2, U6.4 (P00), U7.1 (PGB)
PG_WHEEL: R24.2, U6.5 (P01), U8.1 (PGB)
SCL: J12.1, J12.5, R28.2, U1.5 (SCL), U2.4 (SCL), U4.22 (SCL), U5.2 (A0), U5.4 (SCL), U6.22 (SCL), U11.4 (SCL), U12.4 (SCL), U13.4 (SCL), U14.2 (A0), U14.4 (SCL), U20.4 (SCL), U21.4 (SCL), U22.4 (SCL)
SDA: J12.4, J12.8, R27.2, U1.4 (SDA), U2.5 (SDA), U4.23 (SDA), U5.3 (SDA), U6.23 (SDA), U11.3 (SDA), U12.3 (SDA), U13.2 (A0), U13.3 (SDA), U14.3 (SDA), U20.3 (SDA), U21.3 (SDA), U22.2 (A0), U22.3 (SDA)

Notes on the sheet:
3.3VA is for essential devices (everything necessary to keep i2c running and coulomb counter)
Address 0100000
1000101
1000110
1000100
1000011
1000010
1000000
1000001
Address 0100001
Connectors for additional power zones
Connectors for solar panels
Circuit break trip when Vshunt = 60mV
Soft trip (with timer) at I = 25mV / Rshunt
Time for soft trip determined by capacitor: C = ( 10uA / 1.35V ) * Ttrip
Address 1100100
External MCU monitors battery voltages When balancing necessary, turn on BAL1 or BAL2
To Panel
Address 0011000
1000111
