UWCubeSat/EPS/eps/eps.kicad_pcb

## KiCad design eps/eps.kicad_pcb (continued)

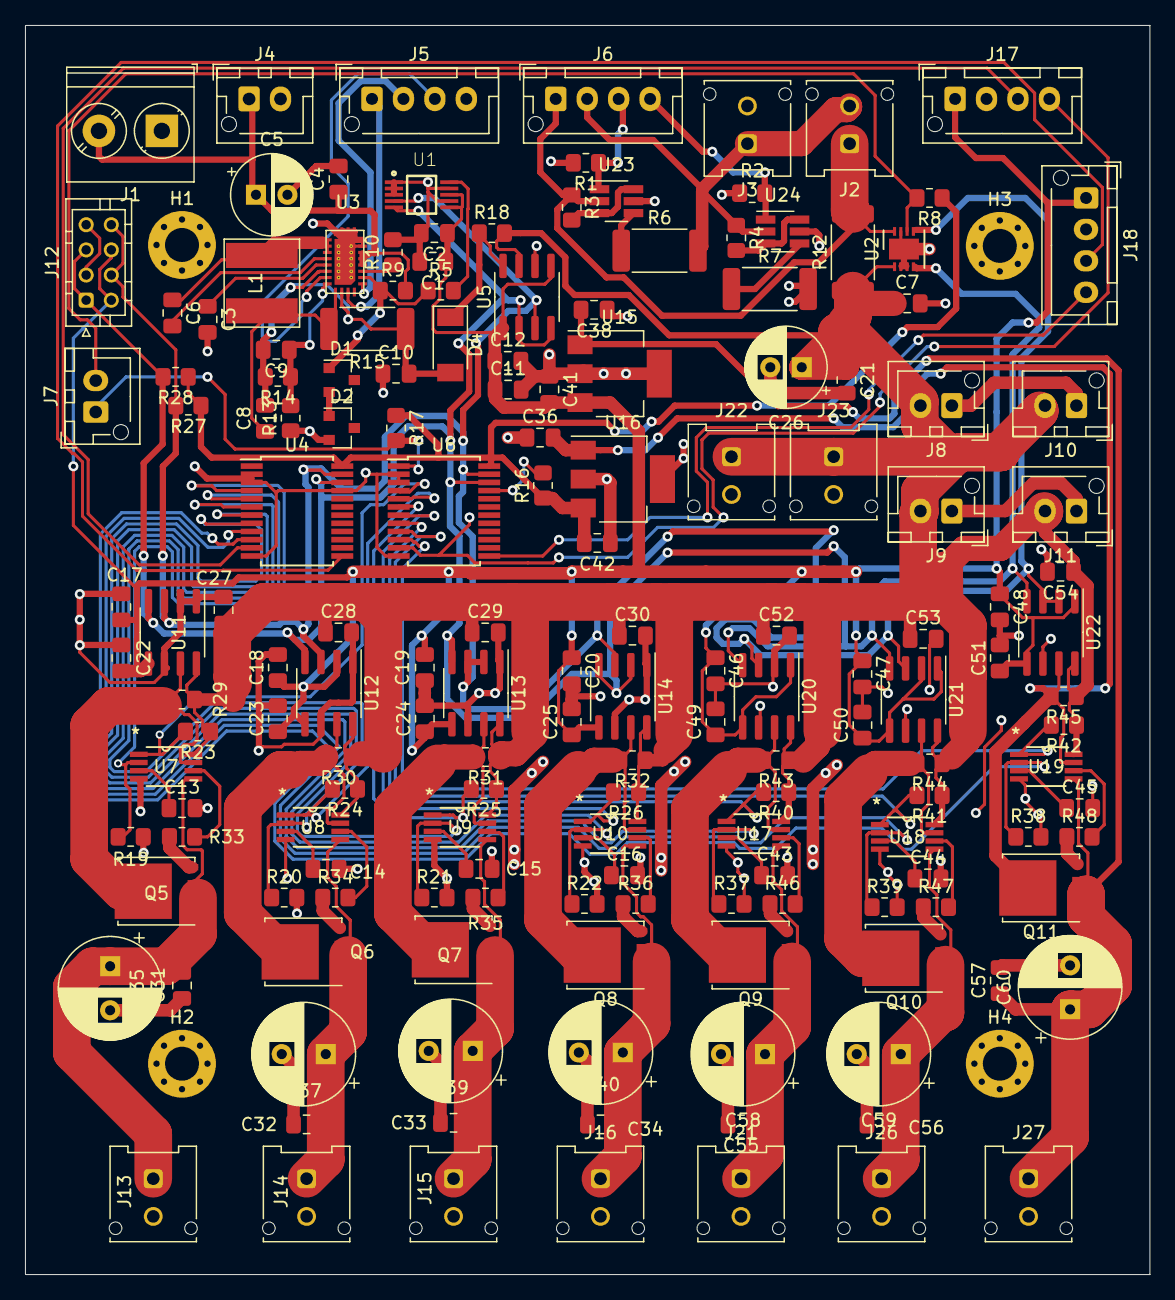
[picture p15: board eps.kicad_pcb from above]

Board: 2 copper layers, 89.4 x 99.3 mm, 169 parts (0 on the bottom side), 85 nets.
