UWCubeSat/EPS/(commit log)

2021-04-20 First Version EPS Schematic
    Unfinished EPS schematic, more details/finished version hopefully soon to come
    [eps.kicad_pcb, eps.sch]
2021-04-27 V1 EPS schematic
    Finished schematic:
    Separated battery, solar, and power monitoring/regulation into different boards.
    Added expansion connectors for more power zones/solar panels
    Added current limiting/short circuit protection
    [battery.kicad_pcb, battery.sch, eps.kicad_pcb, eps.sch, solar.kicad_pcb, solar.sch]
2021-05-25 Maybe Final? PCB Design
    Put everything back on a single board for simplicity after considering that all the connectors between boards would probably make a pretty bad rats nest. Immediately had regrets about this decision after seeing how densely packed the board would have to be to fit within the constraints of Alnis's 1u frame, but pushed onward with design. Also a few of the expansion connectors were removed for size concerns, but other than that I think the schematic is the same as before.
    This design just barely fits within the size constraints, but I am worried about some very long signal traces and if the 3mm power traces and the very segmented ground plane will be able to handle the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
    [battery.kicad_pcb, battery.sch, eps.kicad_pcb, eps.sch, solar.kicad_pcb, solar.sch]
2021-06-19 Finalizing stuff
    Replaced some out of stock parts, fixed some mistakes
    [eps.kicad_pcb, eps.sch]
2021-11-21 Created testing boards folder
    Created folder for all of the boards to test specific chips, and added the INA219B breakout board and the TPS2595x1 breakout board
    [INA219_Breakout.kicad_pcb, INA219_Breakout.sch, TPS2595x1_Breakout.kicad_pcb, TPS2595x1_Breakout.sch]
2021-11-29 BQ25798 Breakout Board Added
    Added the breakout board for the BQ25798 1-4S battery charging circuit
    [BQ25798.kicad_pcb, BQ25798.sch]
2021-12-09 Added More Breakout Boards
    [BQ2920x.kicad_pcb, BQ2920x.sch, BQ298xyz.kicad_pcb, BQ298xyz.sch]
2021-12-09 Moved test-boards folder to eps folder
    [BQ25798.kicad_pcb, BQ25798.sch, BQ2920x.kicad_pcb, BQ2920x.sch, BQ298xyz.kicad_pcb, BQ298xyz.sch, INA219_Breakout.kicad_pcb, INA219_Breakout.sch]
2021-12-09 Moved folder back
    [BQ25798.kicad_pcb, BQ25798.sch, BQ2920x.kicad_pcb, BQ2920x.sch, BQ298xyz.kicad_pcb, BQ298xyz.sch, INA219_Breakout.kicad_pcb, INA219_Breakout.sch]
2021-12-10 Finished Battery Protection Board
    [BQ298xyz.kicad_pcb]
2022-05-17 Did work
    Finished a board, maybe forgot to commit some a while ago?
    [BQ25798-B_Cu.gbl, BQ25798-B_Mask.gbs, BQ25798-B_Paste.gbp, BQ25798-B_SilkS.gbo, BQ25798-Edge_Cuts.gm1, BQ25798-F_Cu.gtl, BQ25798-F_Mask.gts, BQ25798-F_Paste.gtp]
